ImagineXYZ/GPSPassive/Pics/IMG-20160824-WA0027.jpg

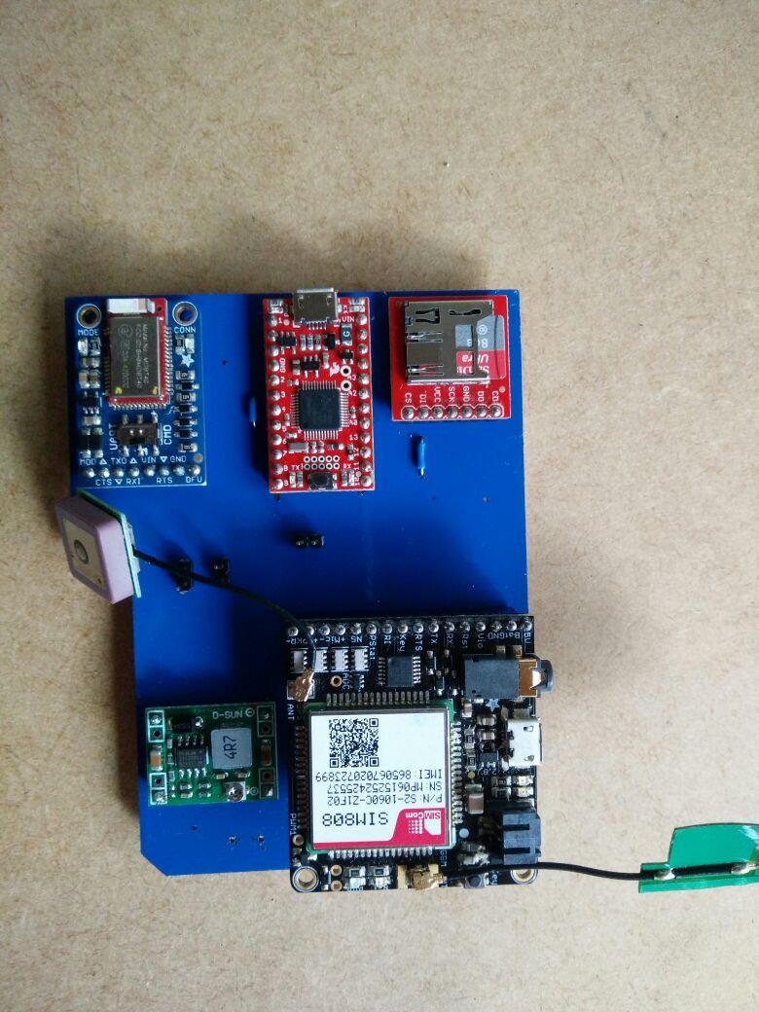
Pics/IMG-20160824-WA0027.jpg
