ImagineXYZ/GPSPassive/Pics/IMG-20160824-WA0009.jpg

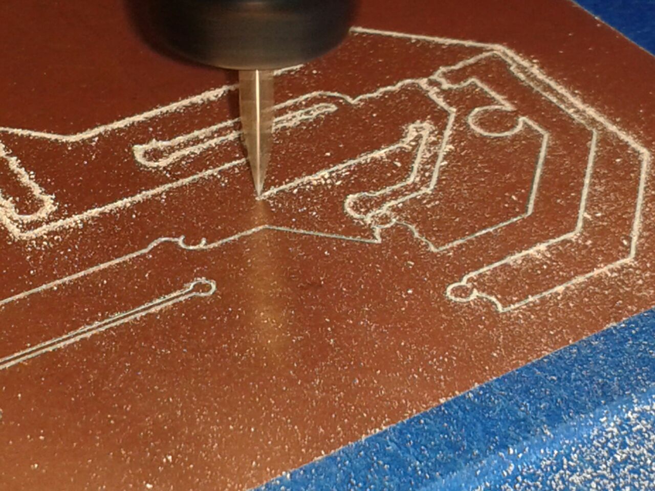
Pics/IMG-20160824-WA0009.jpg
