ImagineXYZ/GPSPassive/Hardware/BLE/ReadMe.txt

Circuitería para el Módulo de Bluetooth de Nordic Semiconductor
Modelo: nRF51822
Link: https://www.nordicsemi.com/eng/Products/Bluetooth-low-energy/nRF51822
