ImagineXYZ/GPSPassive/Hardware/FONA/Readme.txt

Circuitería de soporte para SIM808 en montaje superficial.
Se siguen recomendaciones de la hoja de datos del dispositivo.
