ImagineXYZ/GPSPassive/Hardware/SAMD21/Readme.txt

Circuito necesario para el funcionamiento e interfaz del SAMD21.
