ImagineXYZ/GPSPassive/Hardware/Flash/Readme.txt

Memoria Flash para tarjeta de desarrollo de Hardware (GPSPassive)

Datos de memoria flash de 1GB con comunicación SPI

Modelo: S70FL01GSAGMFI011
