ImagineXYZ/GPSPassive/Hardware/Flash/ComponentePCB/DS/S70FL01_Breakout (PCB - PLOT REPORT).txt

PLOT REPORT
-----------

Report File:        C:\Users\Bryan\Documents\Trabajo\ImagineXYZ\HarwareDevelopment\Git\GPSPassive\Hardware\Flash\ComponentePCB\DS\S70FL01_Breakout (PCB - PLOT REPORT).txt
Report Written:     Wednesday, August 24, 2016
Project Path:       C:\Users\Bryan\Documents\Trabajo\ImagineXYZ\HarwareDevelopment\Git\GPSPassive\Hardware\Flash\ComponentePCB\DS\S70FL01GSAGMFI011_Breakout.prj
Design Path:        C:\Users\Bryan\Documents\Trabajo\ImagineXYZ\HarwareDevelopment\Git\GPSPassive\Hardware\Flash\ComponentePCB\DS\S70FL01_Breakout.pcb
Design Title:       
Created:            16/08/2016 11:09:58 a.m.
Last Saved:         18/08/2016 02:03:26 p.m.
Editing Time:       46 min
Units:              mm (precision 3)

Device Settings
===============

Drill Settings
==============

    Excellon Format 1    Format 3.5 absolute in mm.
    No zero suppression.

Plots Output
============

    Plot Job: "C:\Users\Bryan\Documents\Trabajo\ImagineXYZ\HarwareDevelopment\Git\GPSPassive\Hardware\Flash\ComponentePCB\DS\S70FL01_Breakout.mop"

NC Drill Output
===============

C:\Users\Bryan\Documents\Trabajo\ImagineXYZ\HarwareDevelopment\Git\GPSPassive\Hardware\Flash\ComponentePCB\DS\S70FL01_Breakout - Drill Data - [Through Hole].drl

    Output:
    ---------------------------
    Plated Round Drill Holes
    Plated Slots
    Plated Board Outlines

    Tool  Size         Count   ID
    ------------------------------------
    T001  000.02362 in 16    F
    ------------------------------------
    Total              16
    ------------------------------------

C:\Users\Bryan\Documents\Trabajo\ImagineXYZ\HarwareDevelopment\Git\GPSPassive\Hardware\Flash\ComponentePCB\DS\S70FL01_Breakout - Drill Data - [Through Hole] (Unplated).drl

    Output:
    -----------------------------
    Unplated Round Drill Holes
    Unplated Slots
    Unplated Board Outlines

    Tool  Size         Count   ID
    ------------------------------------
    T001  000.02500 in 1
    ------------------------------------
    Total              1
    ------------------------------------

End Of Report.
