ImagineXYZ/GPSPassive/Hardware/BLE/Notas BLE.docx

El Adafruit Bluefruit LE UART integra un shield (MDBT40 de raytac) en su tarjeta de desarrollo que contiene el BLE nRF51822 de Nordic Semiconductor, la cual se utiliza en el primer prototipo

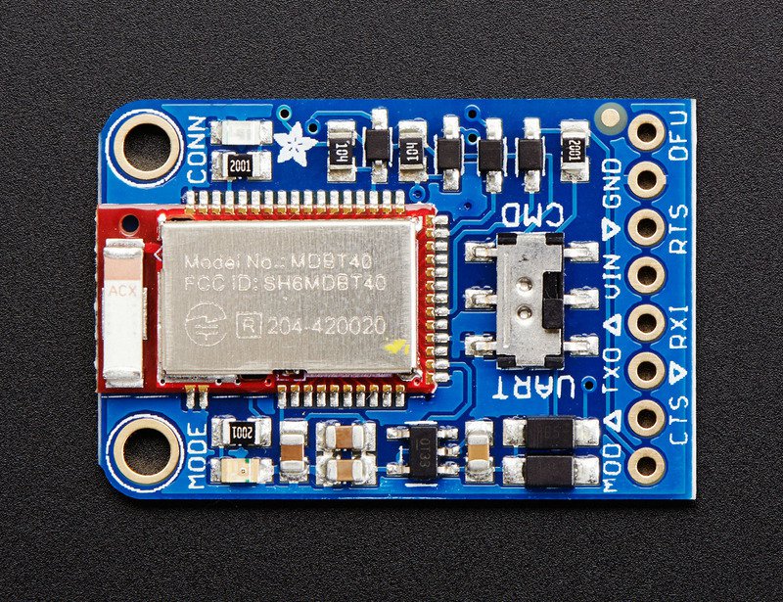
[picture p3: figure]

Configuración recomendada en la hoja de datos

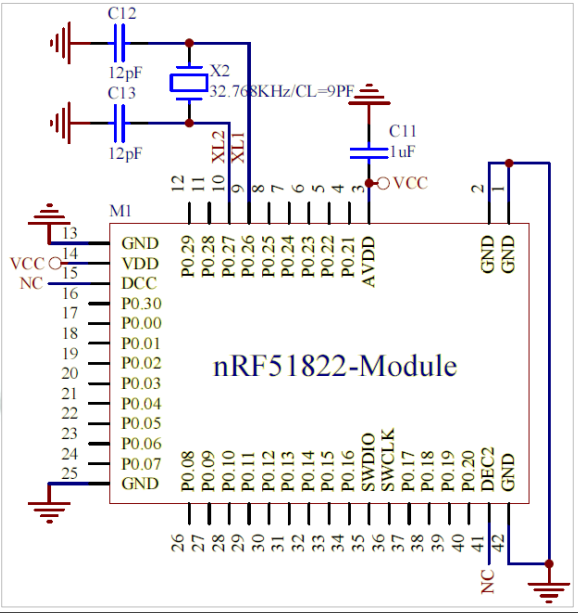
[picture p4: figure]
