ImagineXYZ/GPSPassive/Hardware/SAMD21/Notas SAMD21.docx

Notas SAMD21

Requerimientos de energía

-Se recomienda emplear el circuito a continuación (inductor 10uH)

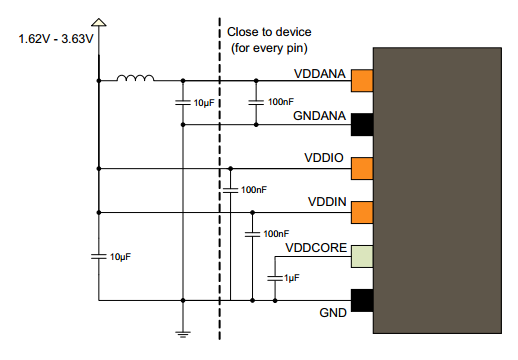
[picture p5: figure]

-Circuito recomendado para reset

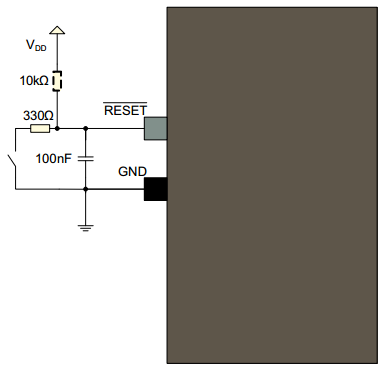
[picture p6: figure]

Requerimientos de reloj

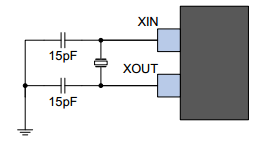
[picture p7: figure]

-Se debe colocar el cristal lo más cerca posible del dispositivo

Recomendaciones de comunicación/debug

-JTAG 10 pines (JTAGICE3)

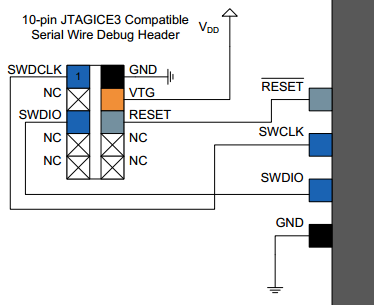
[picture p8: figure]

-USB (circuito recomendado)

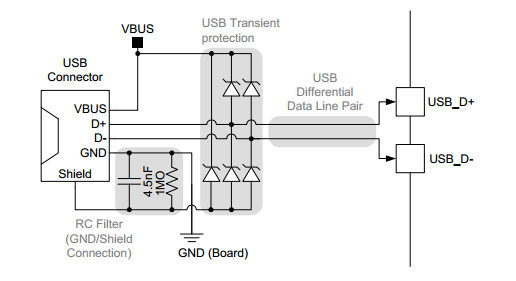
[picture p9: figure]

-Utilizar como referencia circuito de Adafruit Feather

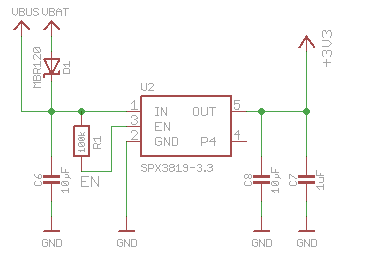
[picture p10: figure]
