ImagineXYZ/GPSPassive/Hardware/SD/Readme.txt

Memoria SD para tarjeta de desarrollo de Hardware (GPSPassive)

Datos de uso de memorias SD en conjunto con el SAMD21
