ImagineXYZ/GPSPassive/Hardware/Flash/Docs/Notas.txt

.No se ha encontrado una biblioteca de componentes de eagle con el componente
