ImagineXYZ/GPSPassive/Hardware/Flash/ComponentePCB/DS/Breakout_S70FL01.png

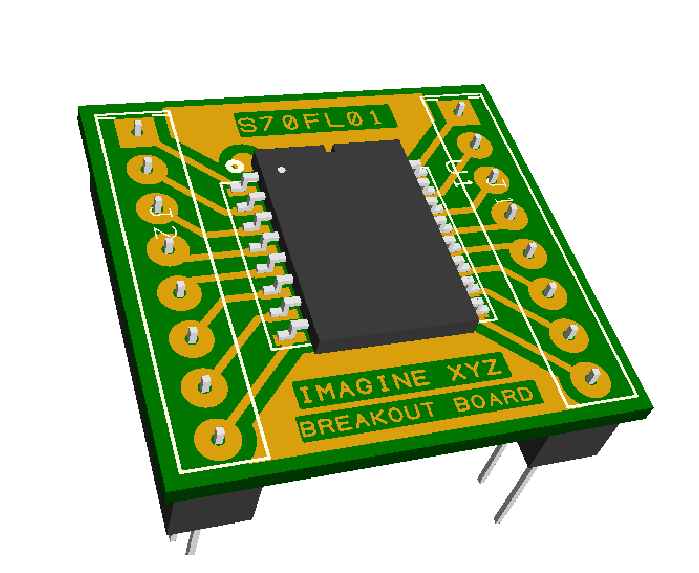
Hardware/Flash/ComponentePCB/DS/Breakout_S70FL01.png
