ImagineXYZ/GPSPassive/Hardware/FONA/Docs/adafruit_products_808schem.png

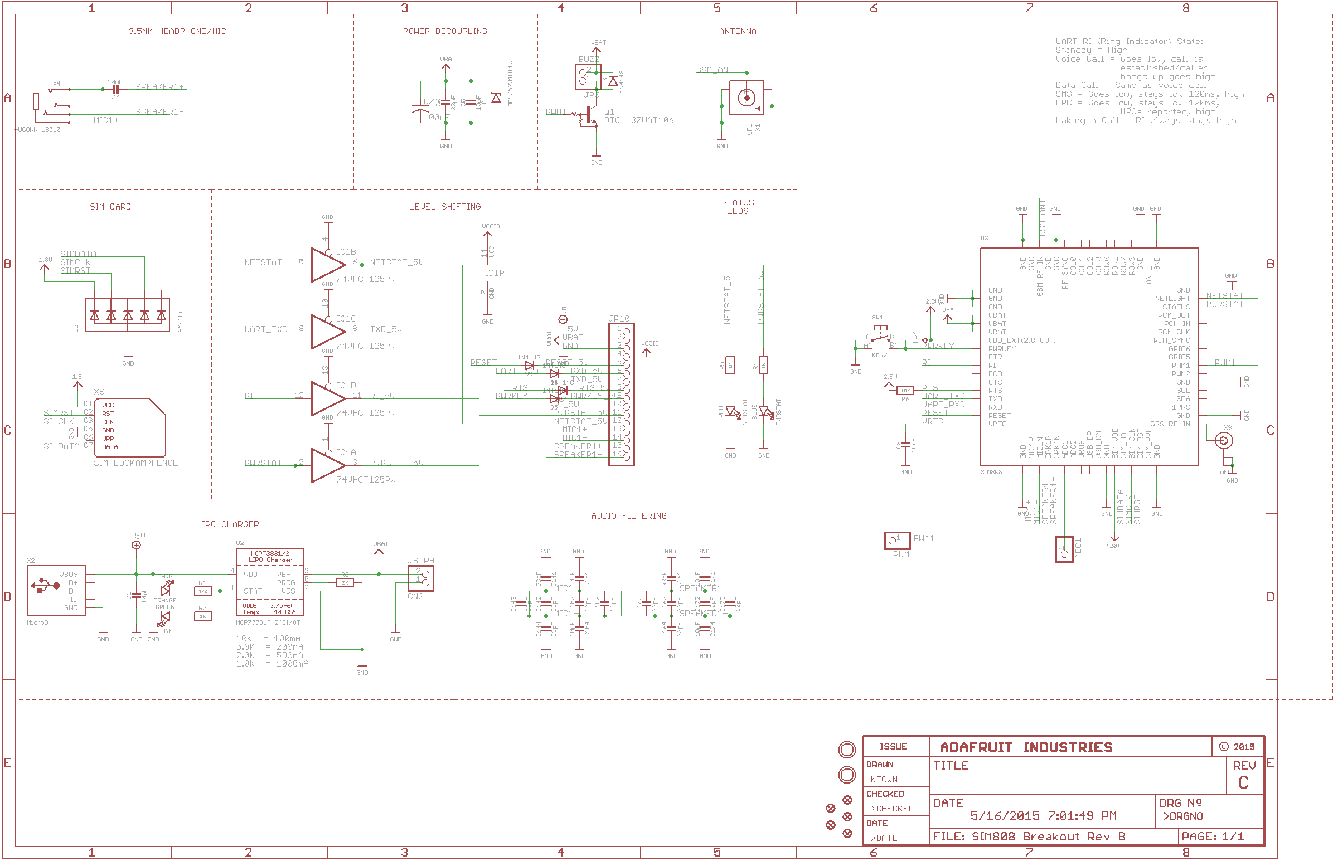
Hardware/FONA/Docs/adafruit_products_808schem.png
