ImagineXYZ/GPSPassive/Pics/IMG-20160623-WA0019.jpg

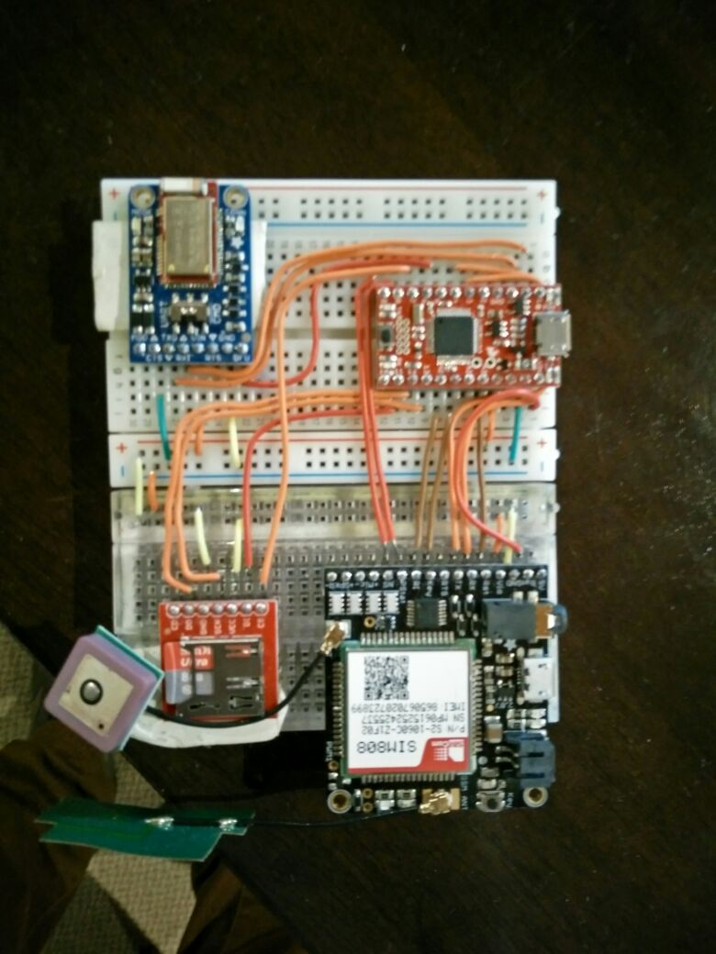
Pics/IMG-20160623-WA0019.jpg
