ImagineXYZ/GPSPassive/Pics/IMG-20160824-WA0017.jpeg

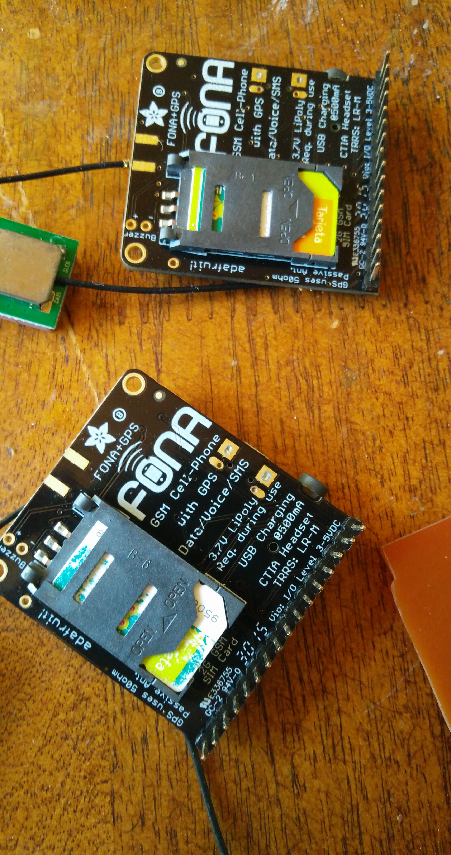
Pics/IMG-20160824-WA0017.jpeg
