ImagineXYZ/GPSPassive/Pics/IMG-20160824-WA0019.jpg

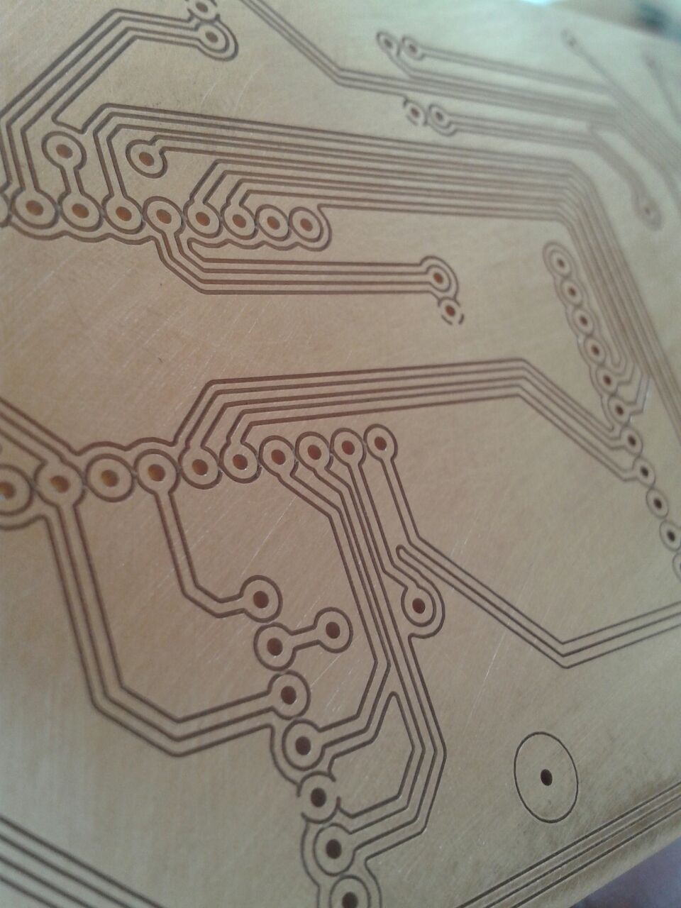
Pics/IMG-20160824-WA0019.jpg
