ImagineXYZ/GPSPassive/Pics/IMG-20160824-WA0020.jpg

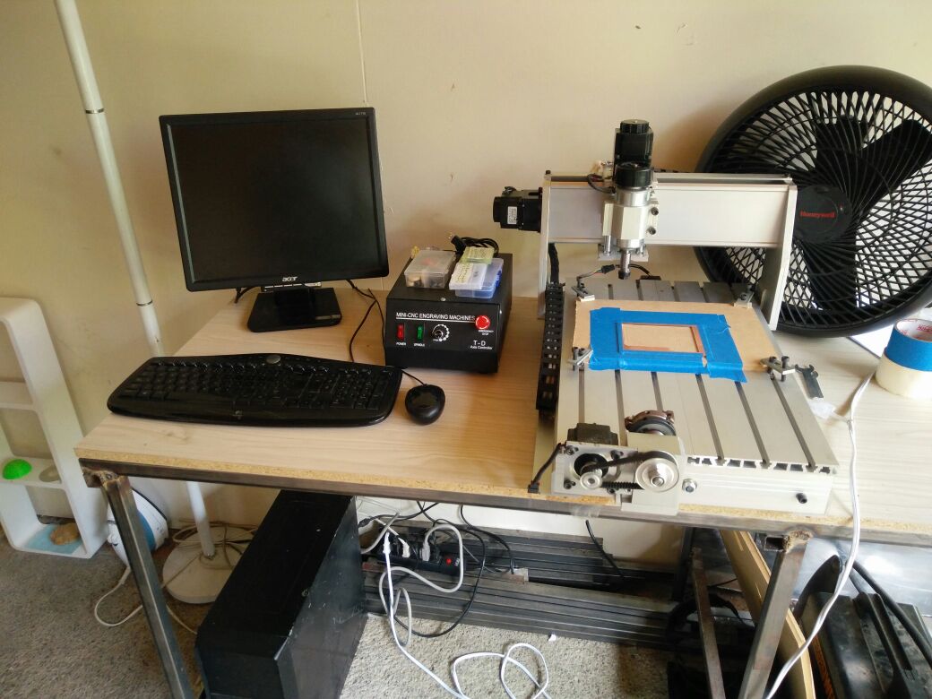
Pics/IMG-20160824-WA0020.jpg
