ImagineXYZ/GPSPassive/Pics/IMG-20160824-WA0023.jpg

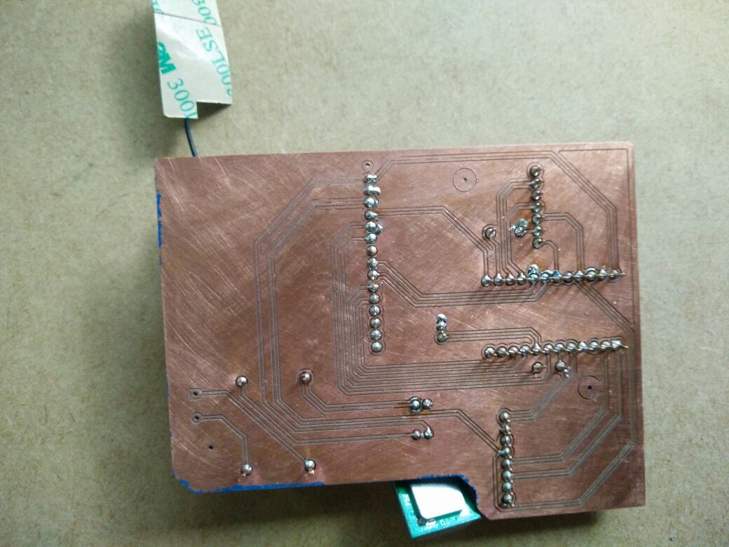
Pics/IMG-20160824-WA0023.jpg
