ImagineXYZ/GPSPassive/Pics/IMG-20160825-WA0015.jpg

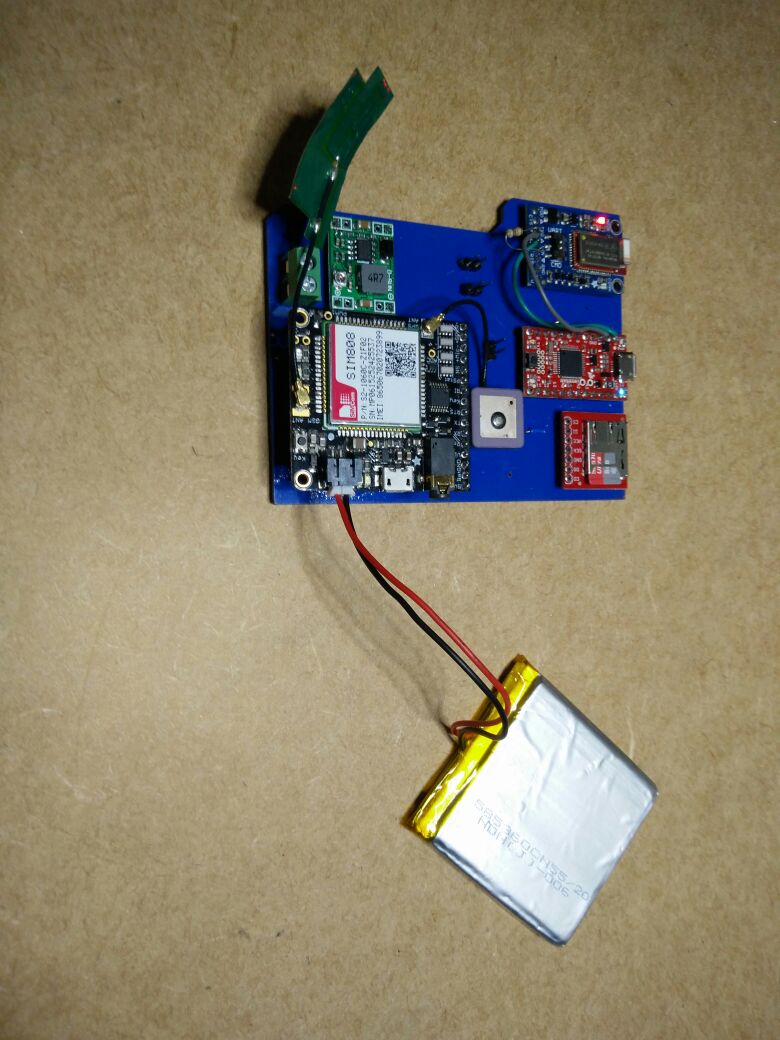
Pics/IMG-20160825-WA0015.jpg
