ImagineXYZ/GPSPassive/Pics/IMG-20160825-WA0016.jpg

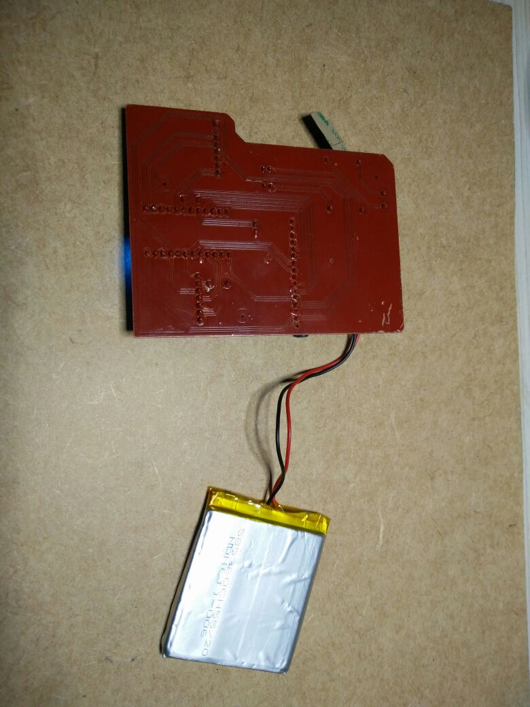
Pics/IMG-20160825-WA0016.jpg
