ImagineXYZ/GPSPassive/Protocolo BT/Diagrama Secuencia BT.png

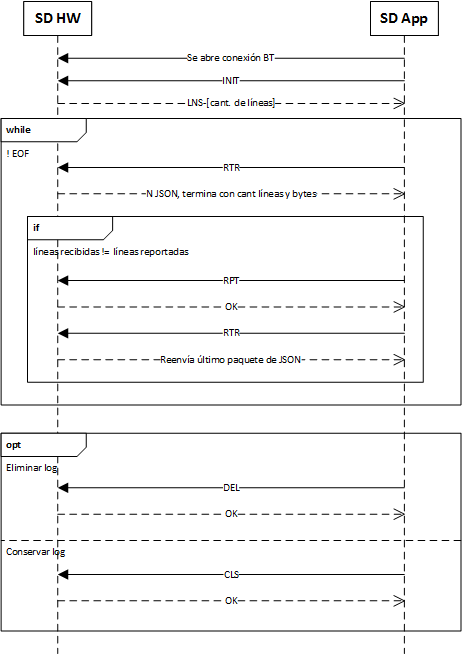
Protocolo BT/Diagrama Secuencia BT.png
