ImagineXYZ/GPSPassive/Hardware/Flash/ComponentePCB/DS/Printing Imprimir.pdf

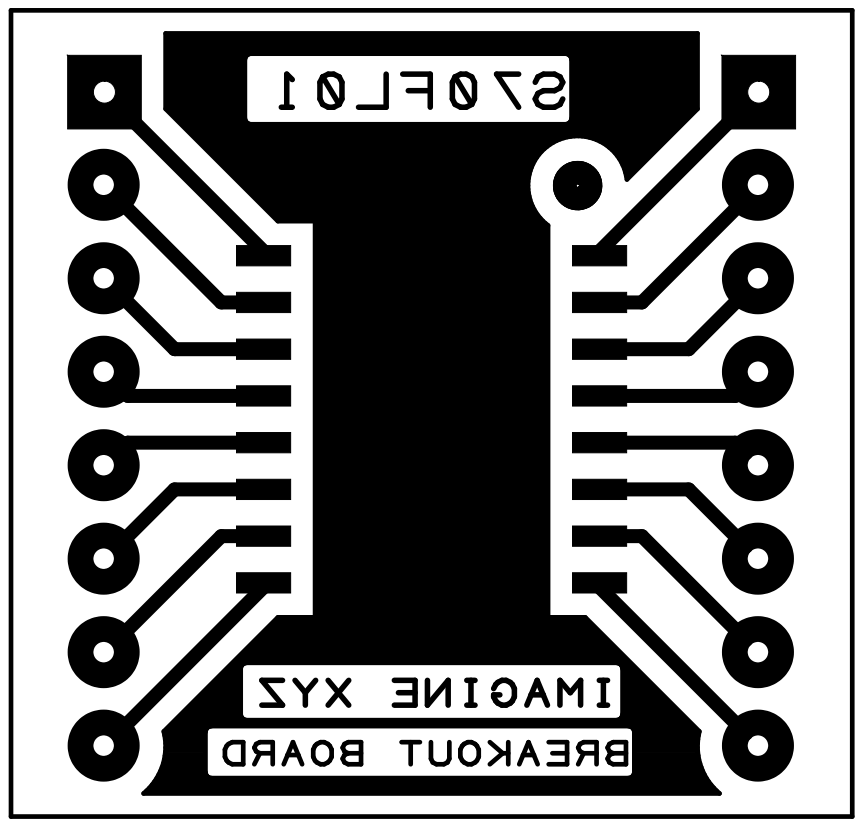
[picture p34: page 1]
