ImagineXYZ/GPSPassive/Hardware/Flash/ComponentePCB/DS/S70FL01_Breakout - PCB.pdf

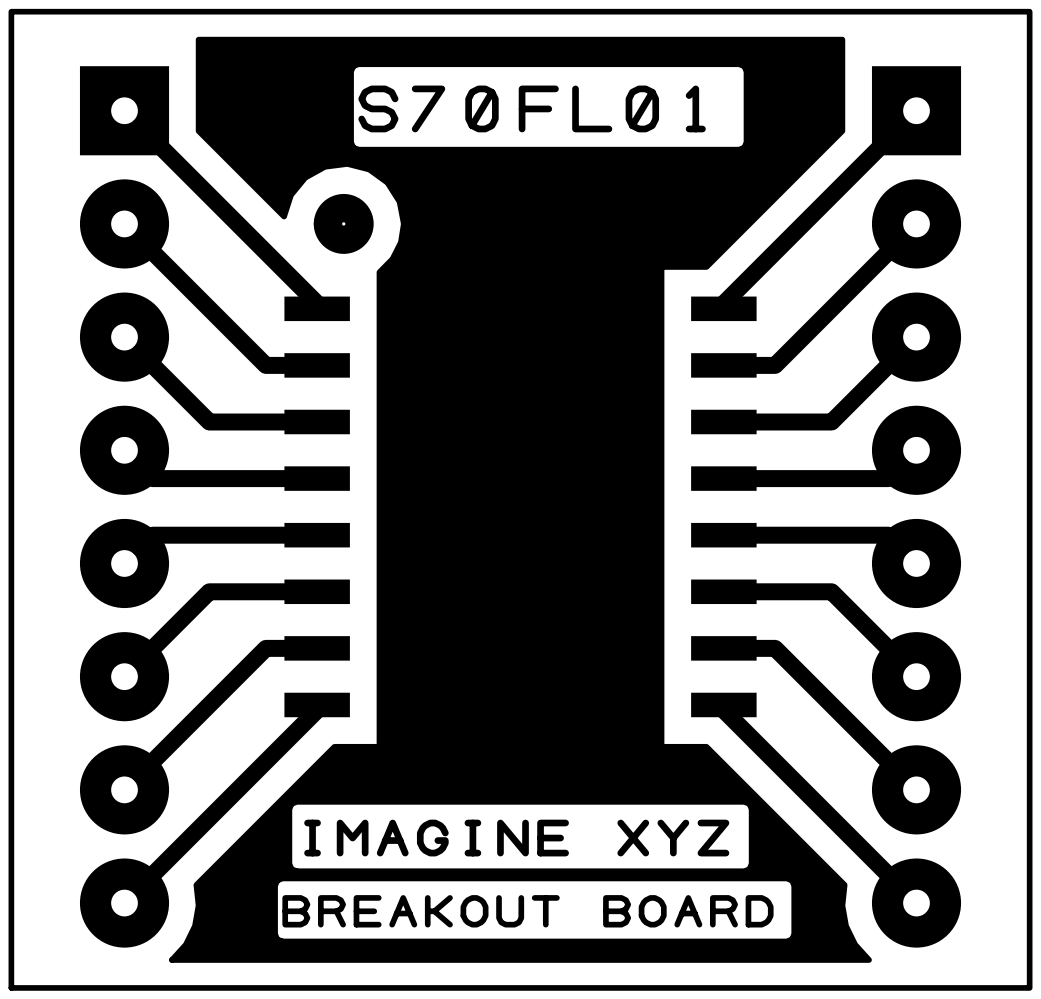
[picture p35: page 1]
