ImagineXYZ/GPSPassive/Eagle Files/RAC.pdf

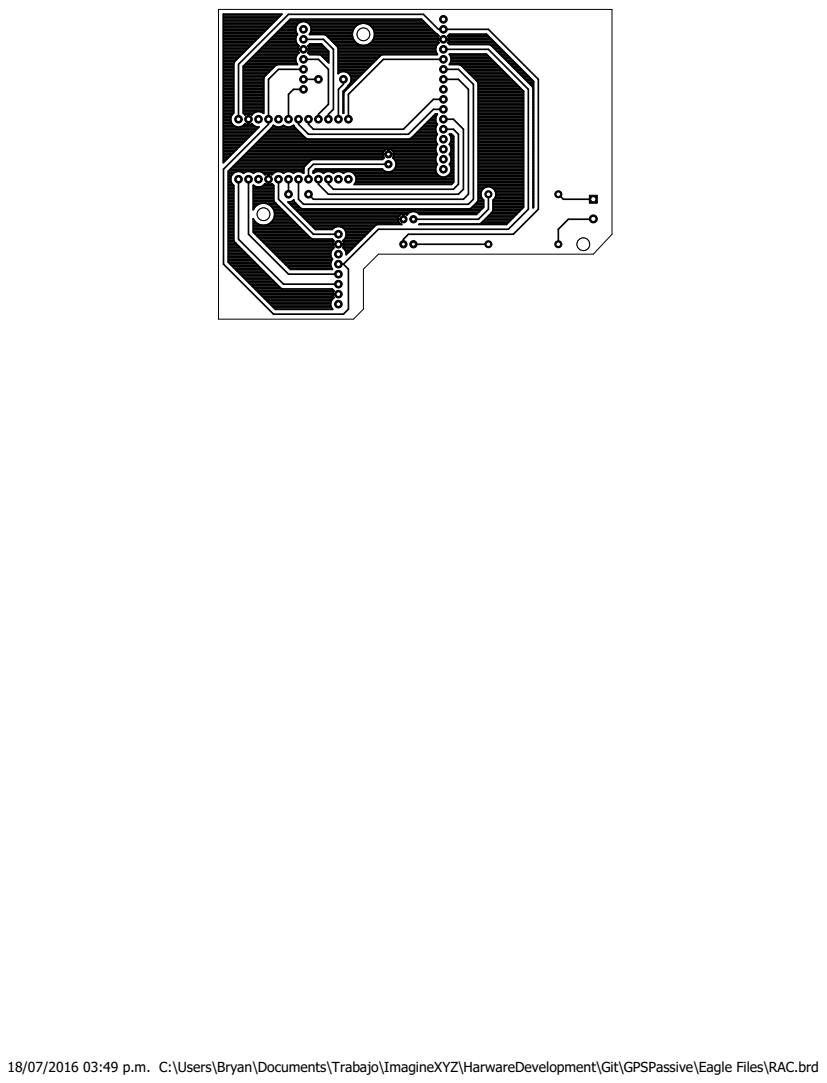
[picture p36: page 1]

18/07/2016 03:49 p.m. C:\Users\Bryan\Documents\Trabajo\ImagineXYZ\HarwareDevelopment\Git\GPSPassive\Eagle Files\RAC.brd
