ImagineXYZ/GPSPassive/(list of files, drawings)

Other design files:
Hardware/Flash/ComponentePCB/DS/S70FL01_Breakout.pcb
Hardware/Flash/ComponentePCB/DS/~S70FL01_Breakout.pcb
