ImagineXYZ/GPSPassive/Eagle Files/GPSPassive.brd

## EAGLE design Eagle Files/GPSPassive.brd (2016-08-31)

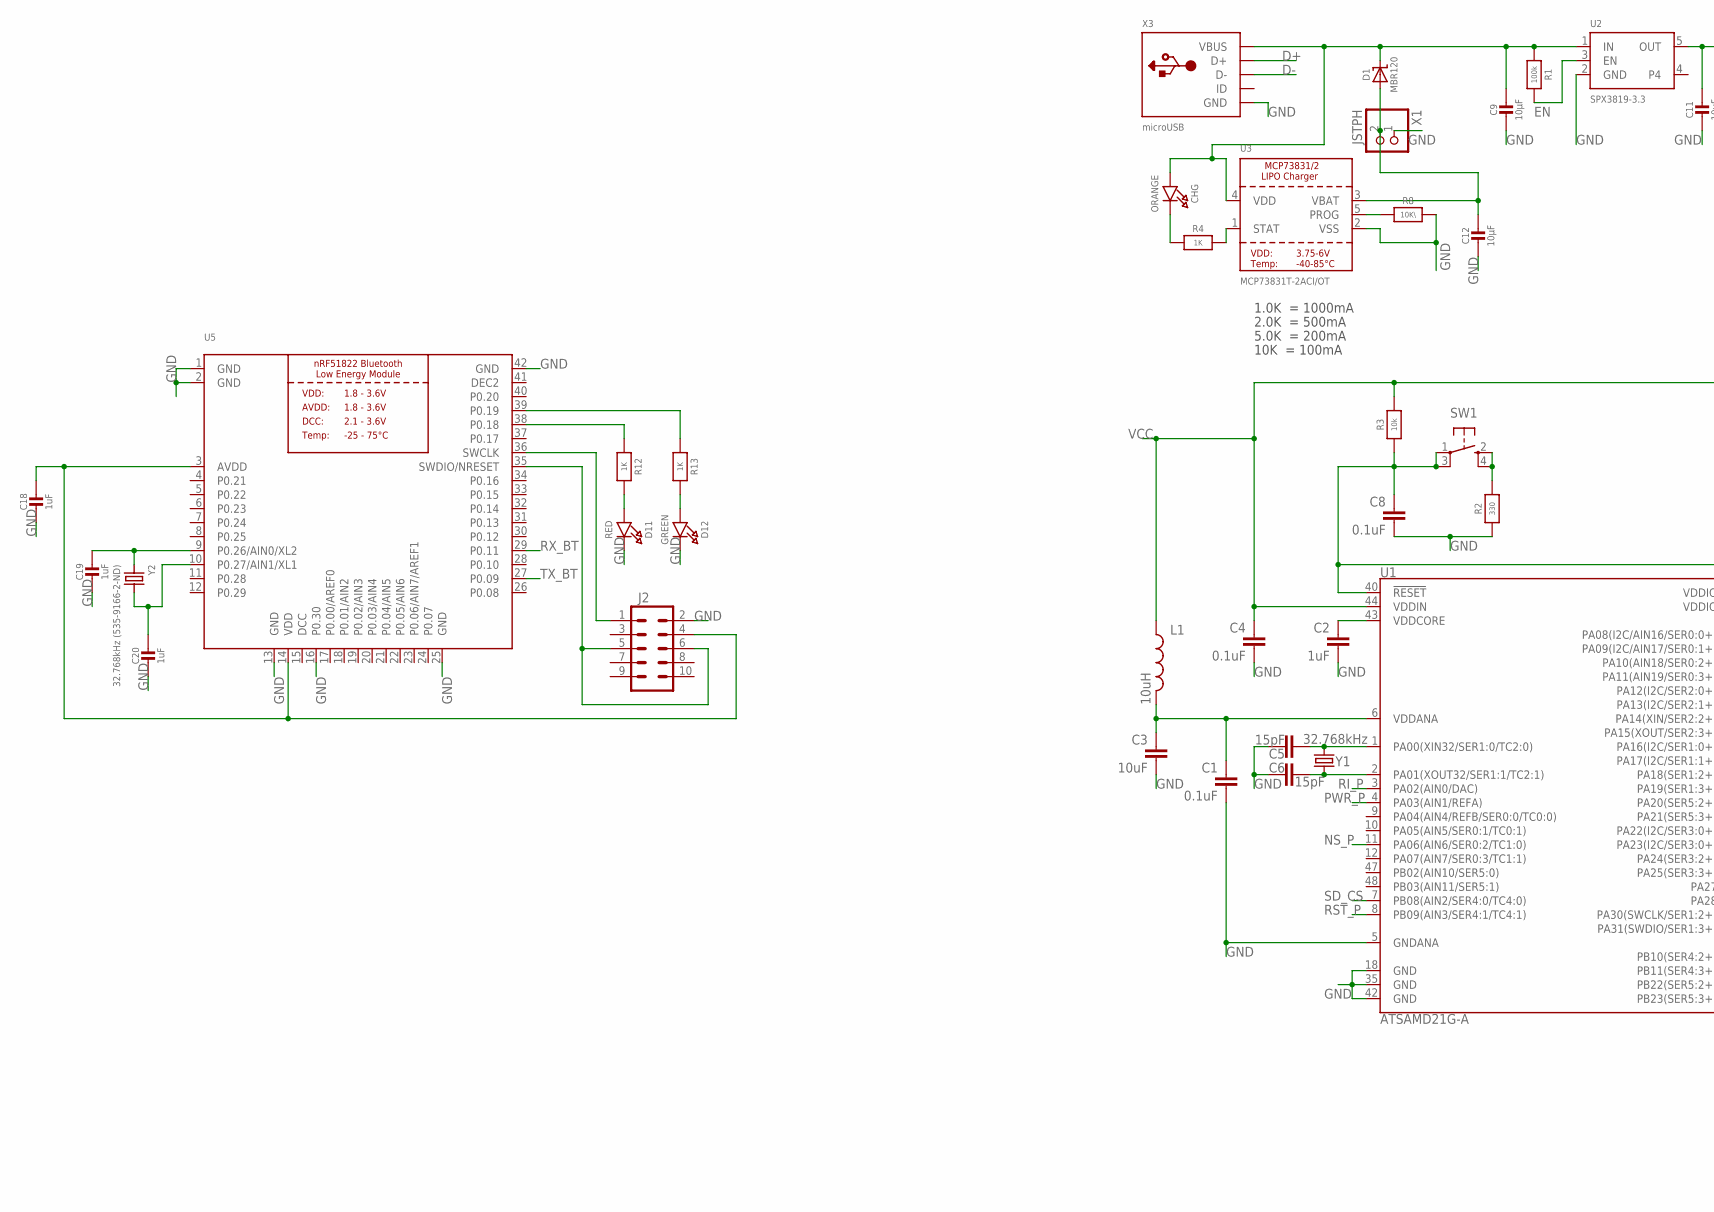
[picture p37: schematic GPSPassive.sch, part in row 1, column 1]

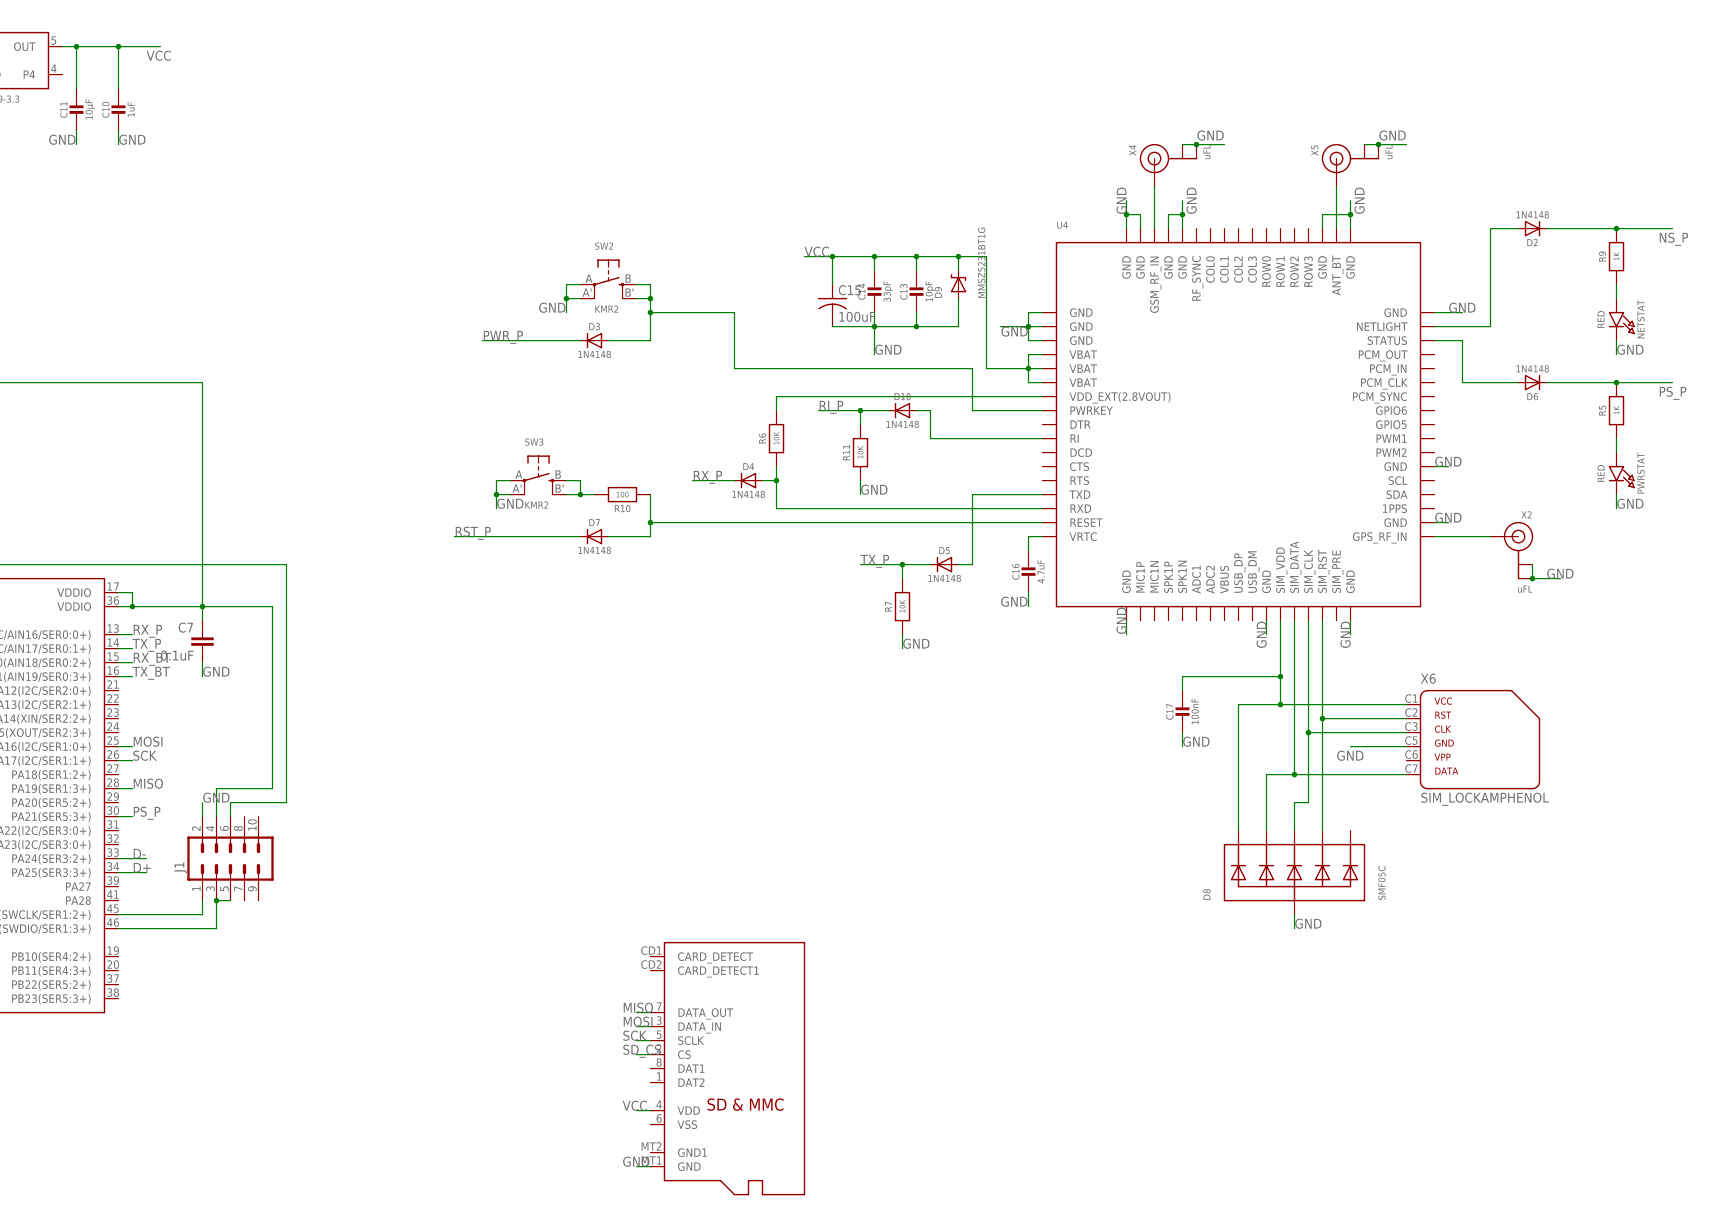
[picture p38: schematic GPSPassive.sch, part in row 1, column 2]

Parts:
C1, C4, C7, C8: 0.1uF; 0402-CAP
C2: 1uF; 0402-CAP
C3: 10uF; 0402-CAP
C5, C6: 15pF; 0402-CAP
C9, C11, C12: 10µF; 0805-NO
C10: 1uF; 0603-NO
C13: 10pF; 0805-NO
C14: 33pF; 0805-NO
C15: 100uF; C1210
C16: 4.7uF; 0805-NO
C17: 100nF; 0805-NO
C18, C19, C20: 1uF; 0805-NO
CHG: ORANGE; CHIPLED_0805_NOOUTLINE
D1: MBR120; SOD-123
D2, D3, D4, D5, D6, D7, D10: 1N4148; SOD-323
D8: SMF05C; SOT363
D9: MMSZ5231BT1G; SOD-123
D11: RED; CHIPLED_0805_NOOUTLINE
D12: GREEN; CHIPLED_0805_NOOUTLINE
J1, J2: M05X2SHD_LOCK; 2X5-SHROUDED_LOCK
L1: 10uH; 0603
NETSTAT: RED; CHIPLED_0805_NOOUTLINE
PWRSTAT: RED; CHIPLED_0805_NOOUTLINE
R1: 100k; 0603-NO
R2: 330; 0603-NO
R3: 10k; 0603-NO
R4: 1K; 0603-NO
R5, R9, R12, R13: 1K; 0805-NO
R6, R7, R11: 10K; 0805-NO
R8: 10K\; 0603-NO
R10: 100; 0805-NO
SW1: SPST_TACT-KMR2; KMR2
SW2, SW3: KMR2; BTN_KMR2_4.6X2.8
U1: ATSAMD21G-A; TQFP-48
U2: SPX3819-3.3; SOT23-5
U3: MCP73831T-2ACI/OT; SOT23-5
U4: GSM_SIM808_LITERAL; SIM900_SMT
U5: NRF51822_MODULE_MDBT40; BLE_MODULE_RAYTAC_MDBT40
U$1: MICROSD
X1: JSTPH; JSTPH2
X2, X4, X5: uFL; U.FL
X3: microUSB; 4UCONN_20329_V2
X6: SIM_LOCKAMPHENOL; C707_10M006_512_2
Y1: 32.768kHz; CRYSTAL-SMD-3.2X1.5MM
Y2: 32.768kHz (535-9166-2-ND); CRYSTAL_CYL_2X6MM_SMT

Connections:
!RESET: C8.1, J1.6, R3.1, SW1.1, SW1.3 (P1), U1.40 (!RESET!)
CONNECTED_LED: R13.1, U5.39 (P0.19)
D+: U1.34 (PA25(SER3:3+)), X3.D+
D-: U1.33 (PA24(SER3:2+)), X3.D-
DCC: U5.15 (DCC)
DEC2: U5.41 (DEC2)
EN: R1.2, U2.3 (EN)
GND: C1.2, C2.2, C3.2, C4.2, C5.1, C6.2, C7.2, C8.2, C9.2, C10.2, C11.2, C12.2, C13.2, C14.2, C15.2, C16.2, C17.2, C18.2, C19.2, C20.2, D8.2 (A), D9.A, D11.C, D12.C, J1.2, J2.2, NETSTAT.C, PWRSTAT.C, R2.1, R7.1, R8.2, R11.1, SW2.A, SW2.A' (P1), SW3.A, SW3.A' (P1), U1.5 (GNDANA), U1.18 (GND), U1.35 (GND), U1.42 (GND), U2.2 (GND), U3.2 (VSS), U4.P$1 (GND), U4.P$2 (GND), U4.P$3 (GND), U4.P$18 (GND), U4.P$28 (GND), U4.P$34 (GND), U4.P$36 (GND), U4.P$40 (GND), U4.P$51 (GND), U4.P$52 (GND), U4.P$54 (GND), U4.P$64 (GND), U4.P$65 (GND), U4.P$67 (GND), U4.P$68 (GND), U5.1 (GND), U5.2 (GND), U5.13 (GND), U5.16 (P0.30), U5.25 (GND), U5.42 (GND), U$1.MT1 (GND), X1.1, X2.1 (GND), X2.2 (GND), X3.BASE@1 (GND), X3.BASE@2 (GND), X3.GND, X3.SPRT@1 (GND), X3.SPRT@2 (GND), X3.SPRT@3 (GND), X3.SPRT@4 (GND), X4.1 (GND), X4.2 (GND), X5.1 (GND), X5.2 (GND), X6.C5 (4)
MISO: U1.28 (PA19(SER1:3+)), U$1.7 (DATA_OUT)
MODE_LED: R12.1, U5.38 (P0.18)
MOSI: U1.25 (PA16(I2C/SER1:0+)), U$1.3 (DATA_IN)
unnamed: C2.1, U1.43 (VDDCORE)
unnamed: C5.2, U1.1 (PA00(XIN32/SER1:0/TC2:0)), Y1.P$2 (2)
unnamed: J1.1, U1.45 (PA30(SWCLK/SER1:2+))
unnamed: C6.1, U1.2 (PA01(XOUT32/SER1:1/TC2:1)), Y1.P$1 (1)
unnamed: J1.3, J1.5, U1.46 (PA31(SWDIO/SER1:3+))
unnamed: C16.1, U4.P$17 (VRTC)
unnamed: R2.2, SW1.2 (S), SW1.4 (S1)
unnamed: R6.2, U4.P$7 (VDD_EXT(2.8VOUT))
unnamed: C12.1, D1.A, U3.3 (VBAT), X1.2
unnamed: CHG.C, R4.1
unnamed: D4.A, R6.1, U4.P$15 (RXD)
unnamed: R4.2, U3.1 (STAT)
unnamed: R8.1, U3.5 (PROG)
unnamed: C9.1, CHG.A, D1.C, R1.1, U2.1 (IN), U3.4 (VDD), X3.VBUS
unnamed: D5.A, U4.P$14 (TXD)
unnamed: D8.5 (C4), U4.P$32 (SIM_RST), X6.C2 (2)
unnamed: D8.4 (C3), U4.P$31 (SIM_CLK), X6.C3 (3)
unnamed: C17.1, D8.1 (C1), U4.P$29 (SIM_VDD), X6.C1 (1)
unnamed: D8.3 (C2), U4.P$30 (SIM_DATA), X6.C7 (6)
unnamed: NETSTAT.A, R9.1
unnamed: PWRSTAT.A, R5.1
unnamed: U4.P$66 (GSM_RF_IN), X4.3 (SIGNAL)
unnamed: U4.P$35 (GPS_RF_IN), X2.3 (SIGNAL)
unnamed: D10.A, U4.P$10 (RI)
unnamed: U4.P$53 (ANT_BT), X5.3 (SIGNAL)
unnamed: D11.A, R12.2
unnamed: D12.A, R13.2
unnamed: C19.1, U5.9 (P0.26/AIN0/XL2), Y2.1
unnamed: C20.1, U5.10 (P0.27/AIN1/XL1), Y2.2
unnamed: C18.1, J2.4, U5.3 (AVDD), U5.14 (VDD)
unnamed: J2.1, U5.36 (SWCLK)
unnamed: J2.5, J2.6, U5.35 (SWDIO/NRESET)
NS: D2.A, U4.P$50 (NETLIGHT)
NS_P: D2.C, R9.2, U1.11 (PA06(AIN6/SER0:2/TC1:0))
PS: D6.A, U4.P$49 (STATUS)
PS_P: D6.C, R5.2, U1.30 (PA21(SER5:3+))
PWRKEY: D3.A, SW2.B (S), SW2.B' (S1), U4.P$8 (PWRKEY)
PWRKEY2: R10.2, SW3.B (S), SW3.B' (S1)
PWR_P: D3.C, U1.4 (PA03(AIN1/REFA))
RI_P: D10.C, R11.2, U1.3 (PA02(AIN0/DAC))
RST: D7.A, R10.1, U4.P$16 (RESET)
RST_P: D7.C, U1.8 (PB09(AIN3/SER4:1/TC4:1))
RX_BT: U1.15 (PA10(AIN18/SER0:2+)), U5.29 (P0.11)
RX_P: D4.C, U1.13 (PA08(I2C/AIN16/SER0:0+))
SCK: U1.26 (PA17(I2C/SER1:1+)), U$1.5 (SCLK)
SD_CS: U1.7 (PB08(AIN2/SER4:0/TC4:0)), U$1.2 (CS)
TX_BT: U1.16 (PA11(AIN19/SER0:3+)), U5.27 (P0.09)
TX_P: D5.C, R7.2, U1.14 (PA09(I2C/AIN17/SER0:1+))
VBUS: U4.P$25 (VBUS)
VCC: C4.1, C7.1, C10.1, C11.1, C13.1, C14.1, C15.1, D9.C, J1.4, L1.1, R3.2, U1.17 (VDDIO), U1.36 (VDDIO), U1.44 (VDDIN), U2.5 (OUT), U4.P$4 (VBAT), U4.P$5 (VBAT), U4.P$6 (VBAT), U$1.4 (VDD)
VDDANA: C1.1, C3.1, L1.2, U1.6 (VDDANA)

Notes on the sheet:
10K = 100mA
5.0K = 200mA
2.0K = 500mA
1.0K = 1000mA

Board: 2 copper layers, 68 parts (0 on the bottom side), 59 nets, no tracks yet.
