ImagineXYZ/GPSPassive/Eagle Files/RAC.brd

## EAGLE design Eagle Files/RAC.brd (2016-08-31)

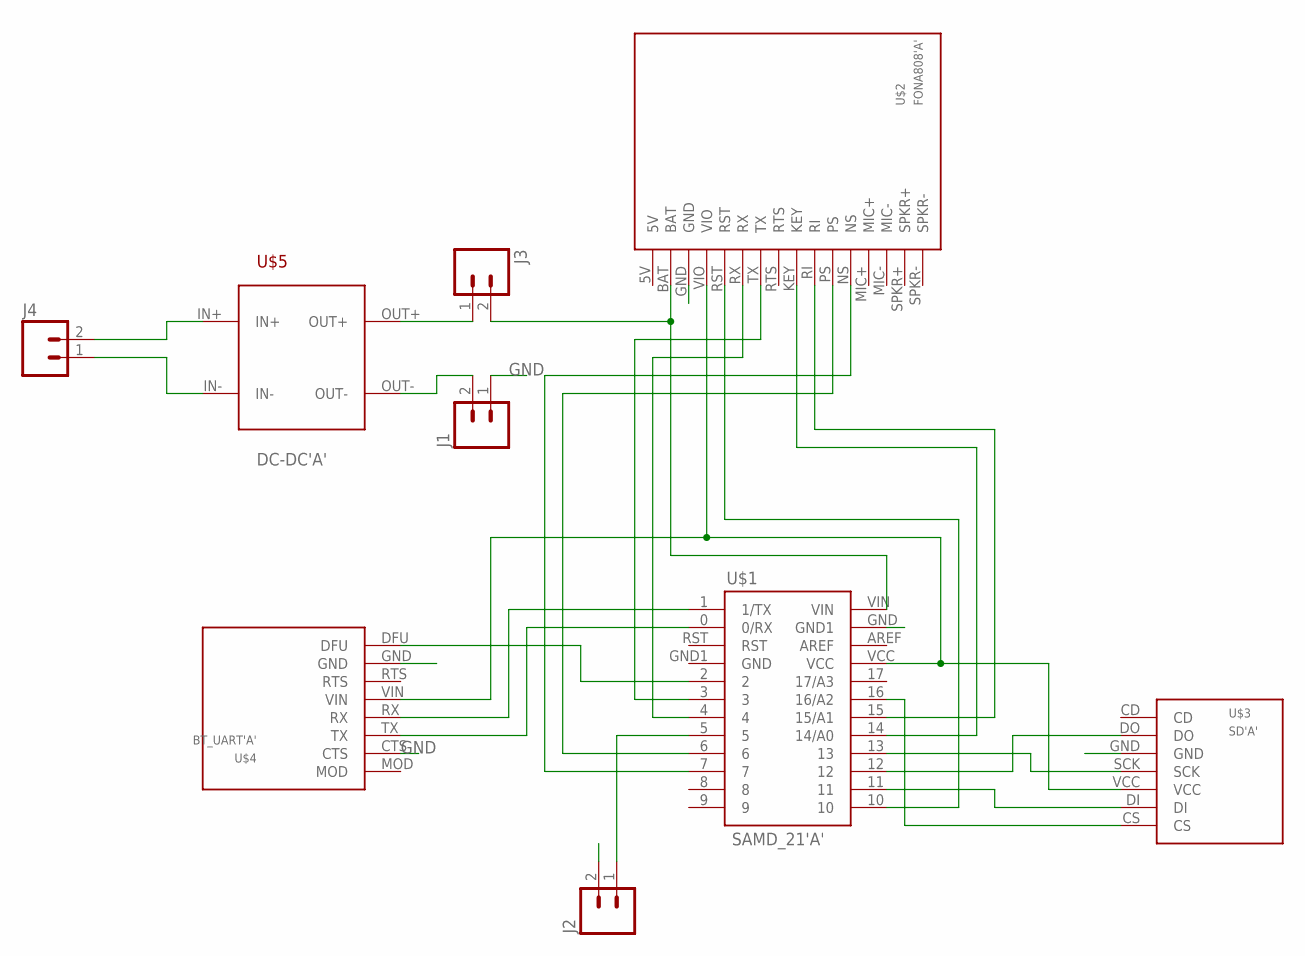
[picture p39: schematic RAC.sch]

Parts:
J1, J2, J3: M02PTH; 1X02
J4: M025MM; SCREWTERMINAL-5MM-2
U$1: SAMD_21'A'; MINI
U$2: FONA808'A'; FONA
U$3: SD'A'; SD_BR
U$4: BT_UART'A'; BLE
U$5: DC-DC'A'; DC-DC

Connections:
GND: J1.1, J2.2, U$1.GND (GND1), U$1.GND1 (GND), U$2.GND, U$3.GND, U$4.CTS, U$4.GND
unnamed: J3.2, U$1.VIN, U$2.BAT
unnamed: U$1.4, U$2.RX
unnamed: U$1.3, U$2.TX
unnamed: U$1.VCC, U$2.VIO, U$3.VCC, U$4.VIN
unnamed: U$1.14 (14/A0), U$2.KEY
unnamed: U$1.15 (15/A1), U$2.RI
unnamed: U$1.10, U$2.RST
unnamed: U$1.11, U$3.DI
unnamed: U$1.12, U$3.DO
unnamed: U$1.13, U$3.SCK
unnamed: U$1.16 (16/A2), U$3.CS
unnamed: U$1.0 (0/RX), U$4.TX
unnamed: U$1.2, U$4.DFU
unnamed: J3.1, U$5.OUT+
unnamed: J1.2, U$5.OUT-
unnamed: J4.2, U$5.IN+
unnamed: J4.1, U$5.IN-
S$1: J2.1, U$1.5
S$2: U$1.6, U$2.PS
S$3: U$1.7, U$2.NS
S$4: U$1.1 (1/TX), U$4.RX

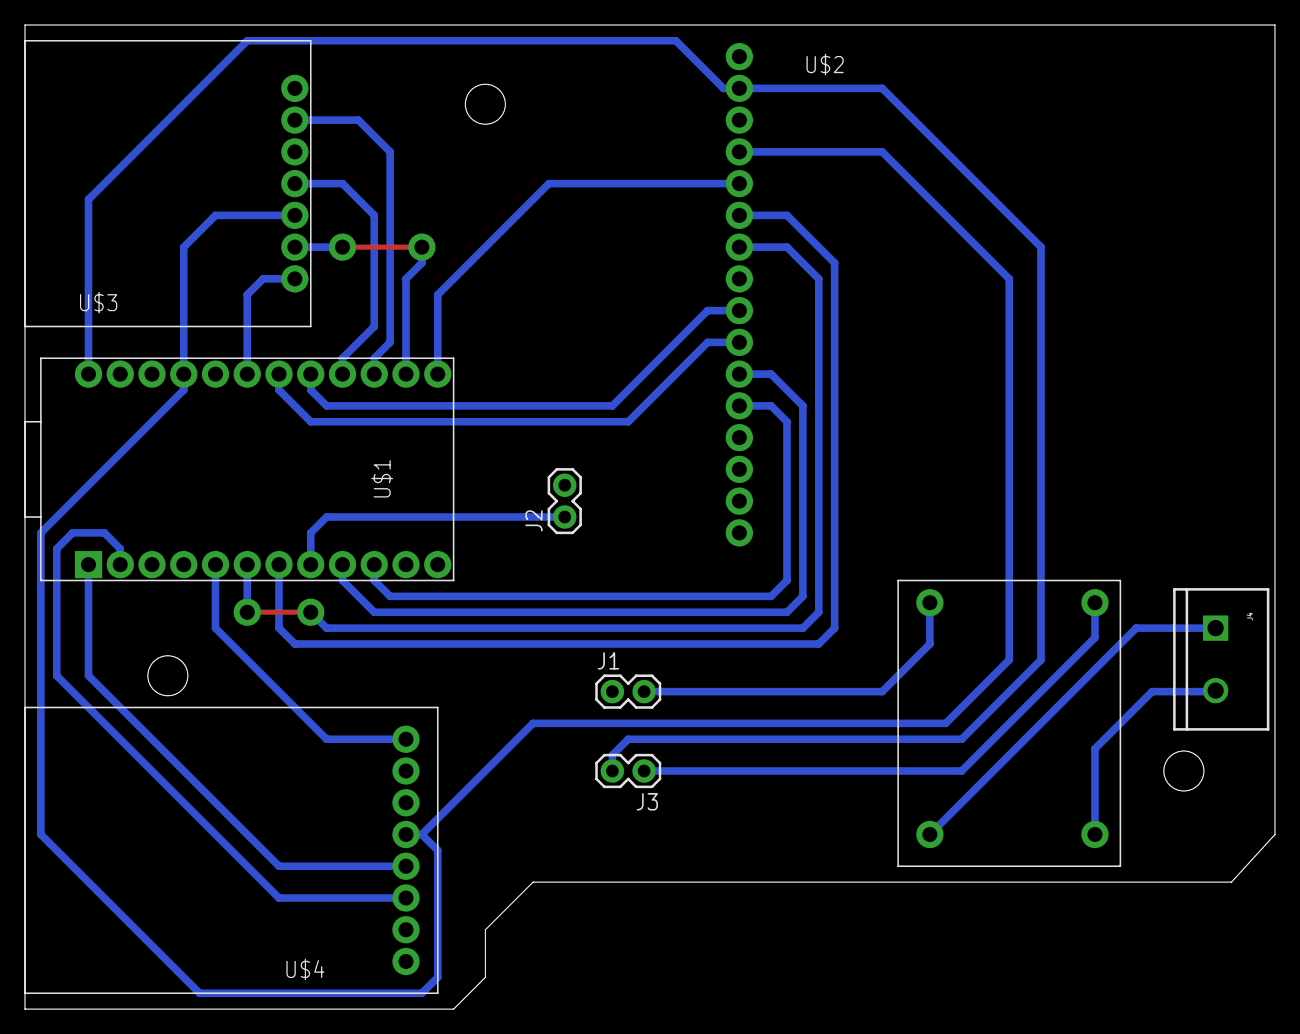
[picture p40: board RAC.brd from above]

Board: 2 copper layers, 100.0 x 78.7 mm, 9 parts (0 on the bottom side), 22 nets.
