ImagineXYZ/GPSPassive/Hardware/BLE/Eagle Files/BLE.sch

## EAGLE design Hardware/BLE/Eagle Files/BLE.sch (2016-08-23)

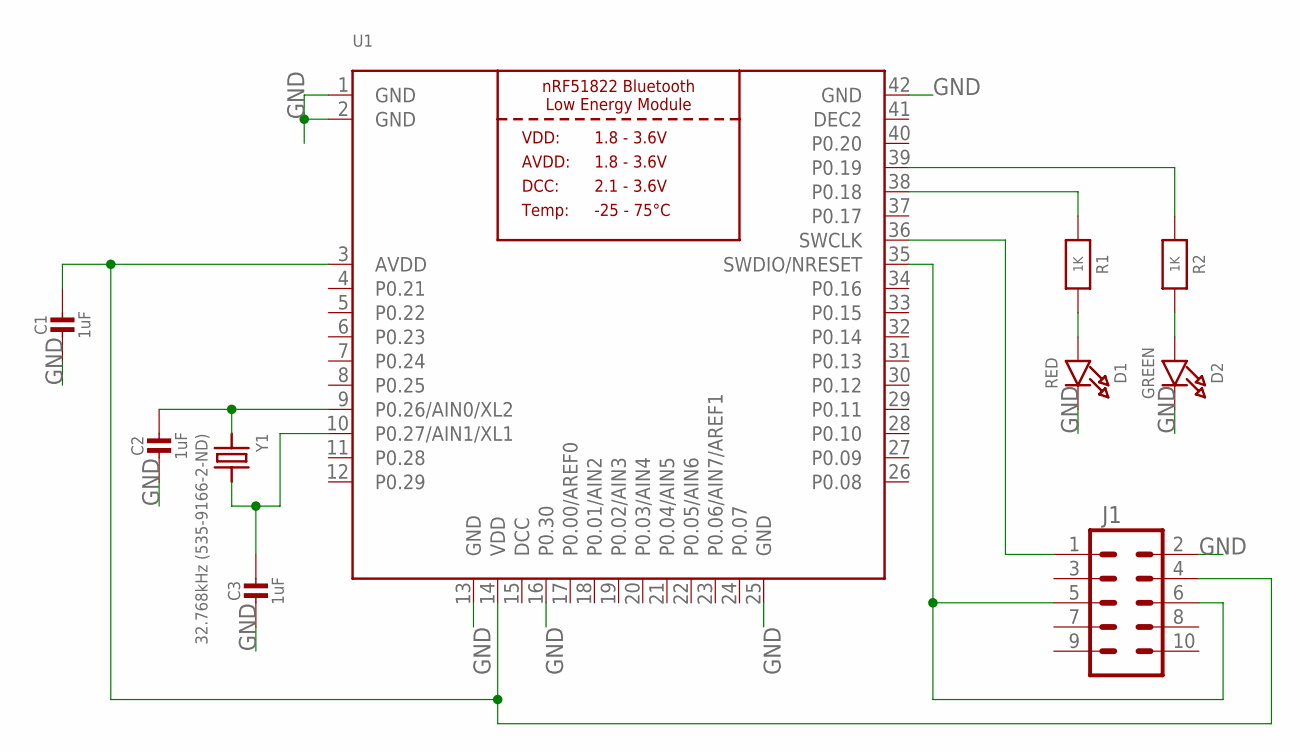
[picture p41: schematic BLE.sch]

Parts:
C1, C2, C3: 1uF; 0805-NO
D1: RED; CHIPLED_0805_NOOUTLINE
D2: GREEN; CHIPLED_0805_NOOUTLINE
J1: M05X2SHD_LOCK; 2X5-SHROUDED_LOCK
R1, R2: 1K; 0805-NO
U1: NRF51822_MODULE_MDBT40; BLE_MODULE_RAYTAC_MDBT40
Y1: 32.768kHz (535-9166-2-ND); CRYSTAL_CYL_2X6MM_SMT

Connections:
CONNECTED_LED: R2.1, U1.39 (P0.19)
GND: C1.2, C2.2, C3.2, D1.C, D2.C, J1.2, U1.1 (GND), U1.2 (GND), U1.13 (GND), U1.16 (P0.30), U1.25 (GND), U1.42 (GND)
MODE_LED: R1.1, U1.38 (P0.18)
unnamed: C2.1, U1.9 (P0.26/AIN0/XL2), Y1.1
unnamed: C3.1, U1.10 (P0.27/AIN1/XL1), Y1.2
unnamed: C1.1, J1.4, U1.3 (AVDD), U1.14 (VDD)
unnamed: J1.1, U1.36 (SWCLK)
unnamed: D1.A, R1.2
unnamed: D2.A, R2.2
unnamed: J1.5, J1.6, U1.35 (SWDIO/NRESET)
