ImagineXYZ/GPSPassive/Hardware/FONA/Eagle Files/SIM808.sch

## EAGLE design Hardware/FONA/Eagle Files/SIM808.sch (2016-08-12)

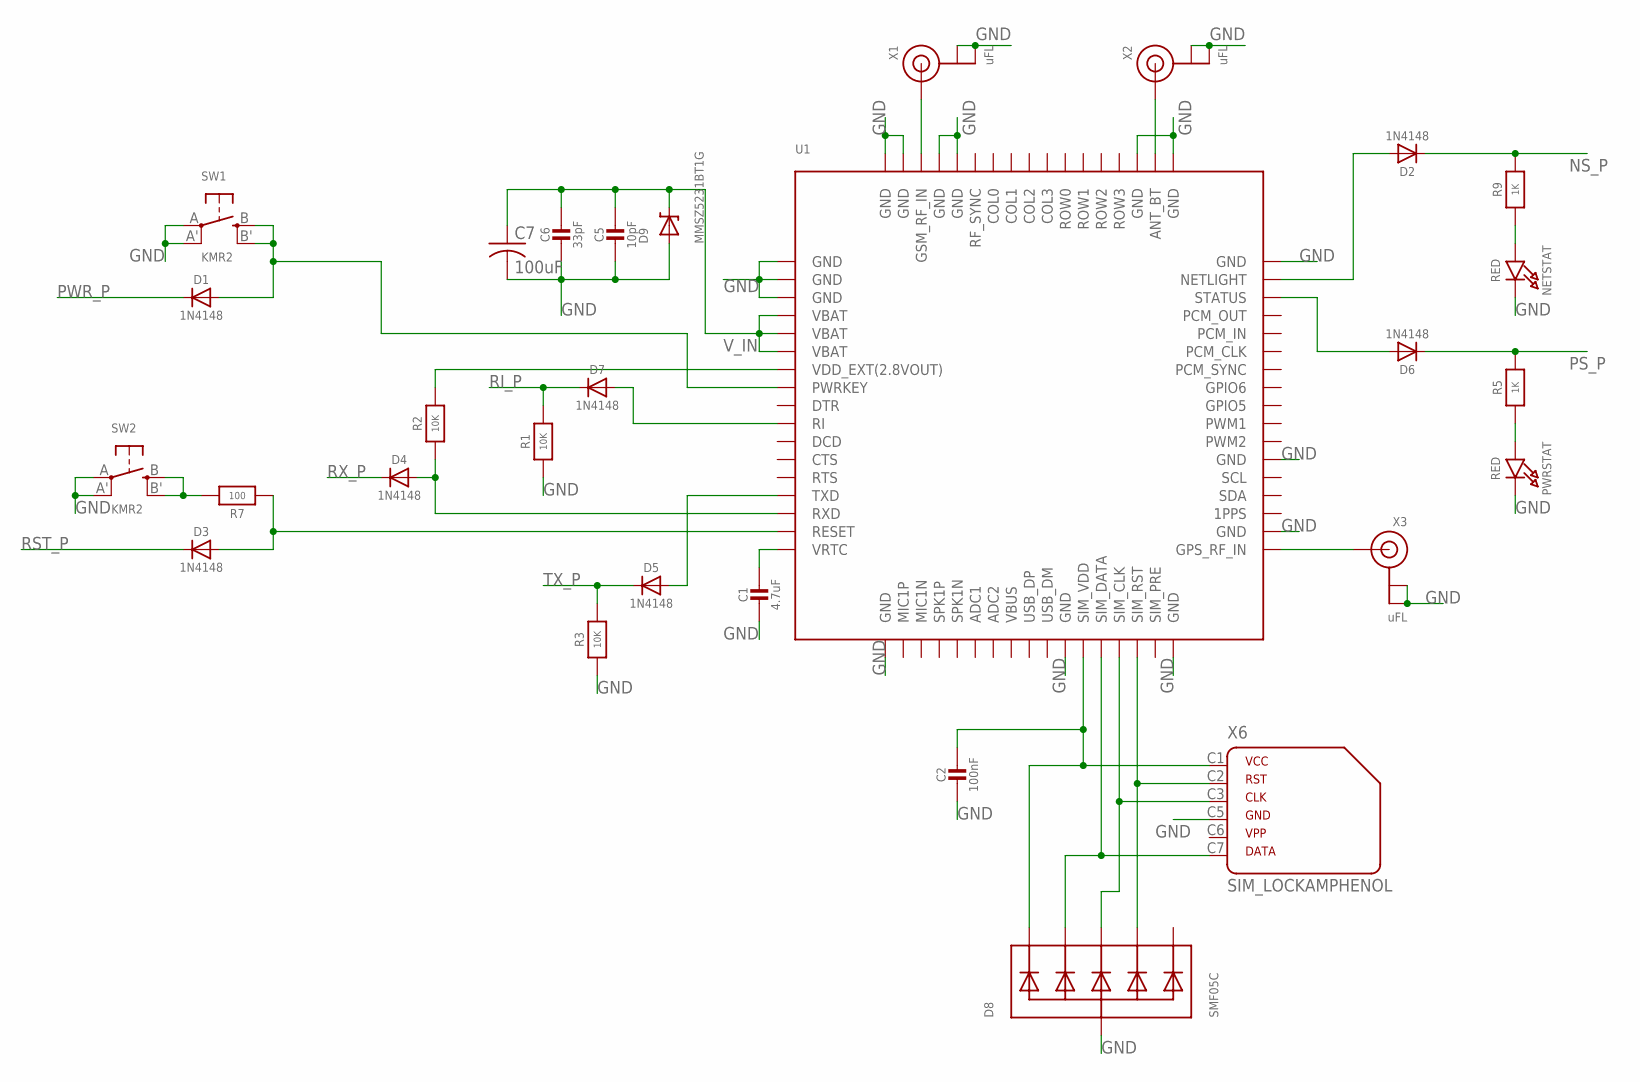
[picture p42: schematic SIM808.sch]

Parts:
C1: 4.7uF; 0805-NO
C2: 100nF; 0805-NO
C5: 10pF; 0805-NO
C6: 33pF; 0805-NO
C7: 100uF; C1210
D1, D2, D3, D4, D5, D6, D7: 1N4148; SOD-323
D8: SMF05C; SOT363
D9: MMSZ5231BT1G; SOD-123
NETSTAT: RED; CHIPLED_0805_NOOUTLINE
PWRSTAT: RED; CHIPLED_0805_NOOUTLINE
R1, R2, R3: 10K; 0805-NO
R5, R9: 1K; 0805-NO
R7: 100; 0805-NO
SW1, SW2: KMR2; BTN_KMR2_4.6X2.8
U1: GSM_SIM808_LITERAL; SIM900_SMT
X1, X2, X3: uFL; U.FL
X6: SIM_LOCKAMPHENOL; C707_10M006_512_2

Connections:
GND: C1.2, C2.2, C5.2, C6.2, C7.2, D8.2 (A), D9.A, NETSTAT.C, PWRSTAT.C, R1.1, R3.1, SW1.A, SW1.A' (P1), SW2.A, SW2.A' (P1), U1.P$1 (GND), U1.P$2 (GND), U1.P$3 (GND), U1.P$18 (GND), U1.P$28 (GND), U1.P$34 (GND), U1.P$36 (GND), U1.P$40 (GND), U1.P$51 (GND), U1.P$52 (GND), U1.P$54 (GND), U1.P$64 (GND), U1.P$65 (GND), U1.P$67 (GND), U1.P$68 (GND), X1.1 (GND), X1.2 (GND), X2.1 (GND), X2.2 (GND), X3.1 (GND), X3.2 (GND), X6.C5 (4)
unnamed: C1.1, U1.P$17 (VRTC)
unnamed: D7.A, U1.P$10 (RI)
unnamed: U1.P$35 (GPS_RF_IN), X3.3 (SIGNAL)
unnamed: R2.2, U1.P$7 (VDD_EXT(2.8VOUT))
unnamed: D4.A, R2.1, U1.P$15 (RXD)
unnamed: D5.A, U1.P$14 (TXD)
unnamed: PWRSTAT.A, R5.1
unnamed: D8.5 (C4), U1.P$32 (SIM_RST), X6.C2 (2)
unnamed: D8.4 (C3), U1.P$31 (SIM_CLK), X6.C3 (3)
unnamed: C2.1, D8.1 (C1), U1.P$29 (SIM_VDD), X6.C1 (1)
unnamed: U1.P$66 (GSM_RF_IN), X1.3 (SIGNAL)
unnamed: D8.3 (C2), U1.P$30 (SIM_DATA), X6.C7 (6)
unnamed: NETSTAT.A, R9.1
NS: D2.A, U1.P$50 (NETLIGHT)
NS_P: D2.C, R9.2
PS: D6.A, U1.P$49 (STATUS)
PS_P: D6.C, R5.2
PWRKEY: D1.A, SW1.B (S), SW1.B' (S1), U1.P$8 (PWRKEY)
PWRKEY2: R7.2, SW2.B (S), SW2.B' (S1)
PWR_P: D1.C
RI_P: D7.C, R1.2
RST: D3.A, R7.1, U1.P$16 (RESET)
RST_P: D3.C
RX_P: D4.C
TX_P: D5.C, R3.2
V_IN: C5.1, C6.1, C7.1, D9.C, U1.P$4 (VBAT), U1.P$5 (VBAT), U1.P$6 (VBAT)
