ImagineXYZ/GPSPassive/Hardware/SAMD21/Eagle Files/SAMD21.sch

## EAGLE design Hardware/SAMD21/Eagle Files/SAMD21.sch (2016-07-19)

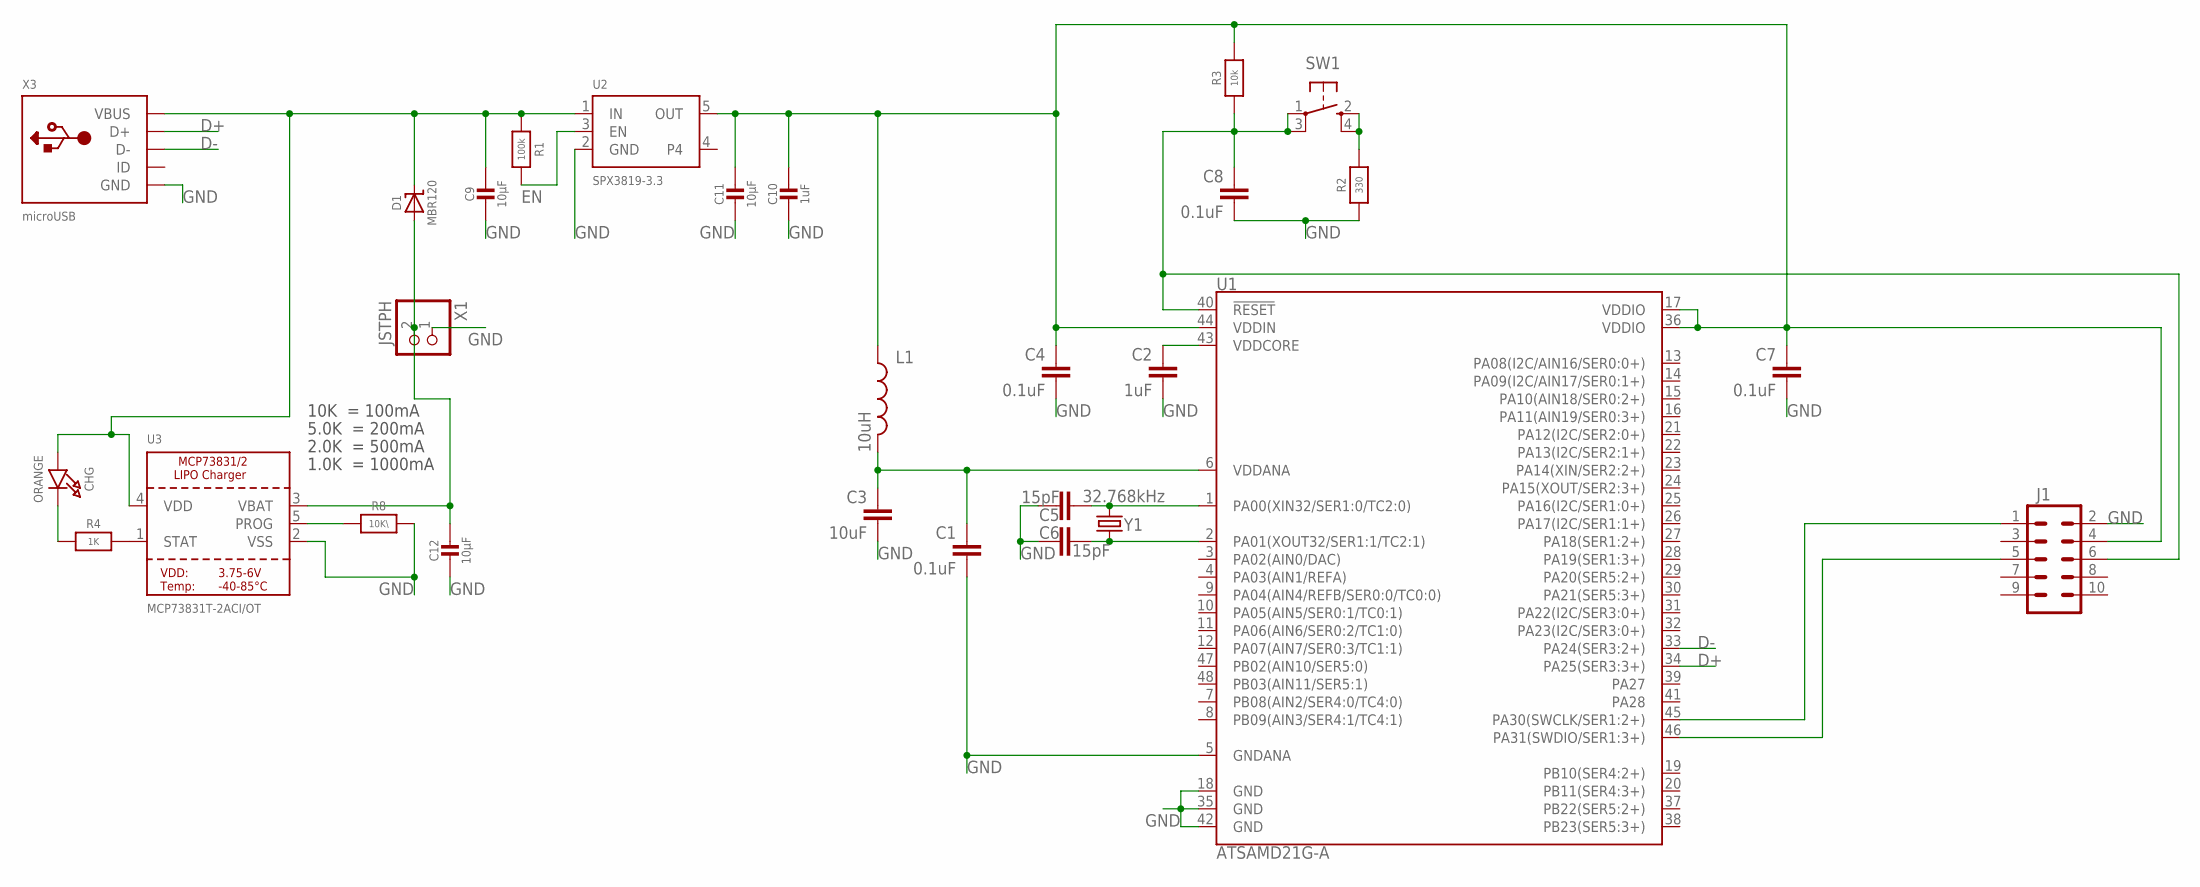
[picture p43: schematic SAMD21.sch]

Parts:
C1, C4, C7, C8: 0.1uF; 0402-CAP
C2: 1uF; 0402-CAP
C3: 10uF; 0402-CAP
C5, C6: 15pF; 0402-CAP
C9, C11, C12: 10µF; 0805-NO
C10: 1uF; 0603-NO
CHG: ORANGE; CHIPLED_0805_NOOUTLINE
D1: MBR120; SOD-123
J1: M05X2SHD_LOCK; 2X5-SHROUDED_LOCK
L1: 10uH; 0603
R1: 100k; 0603-NO
R2: 330; 0603-NO
R3: 10k; 0603-NO
R4: 1K; 0603-NO
R8: 10K\; 0603-NO
SW1: SPST_TACT-KMR2; KMR2
U1: ATSAMD21G-A; TQFP-48
U2: SPX3819-3.3; SOT23-5
U3: MCP73831T-2ACI/OT; SOT23-5
X1: JSTPH; JSTPH2
X3: microUSB; 4UCONN_20329_V2
Y1: 32.768kHz; CRYSTAL-SMD-3.2X1.5MM

Connections:
!RESET: C8.1, J1.6, R3.1, SW1.1, SW1.3 (P1), U1.40 (!RESET!)
D+: U1.34 (PA25(SER3:3+)), X3.D+
D-: U1.33 (PA24(SER3:2+)), X3.D-
EN: R1.2, U2.3 (EN)
GND: C1.2, C2.2, C3.2, C4.2, C5.1, C6.2, C7.2, C8.2, C9.2, C10.2, C11.2, C12.2, J1.2, R2.1, R8.2, U1.5 (GNDANA), U1.18 (GND), U1.35 (GND), U1.42 (GND), U2.2 (GND), U3.2 (VSS), X1.1, X3.BASE@1 (GND)
unnamed: C2.1, U1.43 (VDDCORE)
unnamed: C5.2, Y1.P$2 (2)
unnamed: J1.1, U1.45 (PA30(SWCLK/SER1:2+))
unnamed: C6.1, Y1.P$1 (1)
unnamed: J1.5, U1.46 (PA31(SWDIO/SER1:3+))
unnamed: R2.2, SW1.2 (S), SW1.4 (S1)
unnamed: C12.1, D1.A, U3.3 (VBAT), X1.2
unnamed: CHG.C, R4.1
unnamed: R4.2, U3.1 (STAT)
unnamed: R8.1, U3.5 (PROG)
unnamed: C9.1, CHG.A, D1.C, R1.1, U2.1 (IN), U3.4 (VDD), X3.VBUS
OUT: C4.1, C7.1, C10.1, C11.1, J1.4, L1.1, R3.2, U1.17 (VDDIO), U1.36 (VDDIO), U1.44 (VDDIN), U2.5 (OUT)
VDDANA: C1.1, C3.1, L1.2, U1.6 (VDDANA)

Notes on the sheet:
10K = 100mA
5.0K = 200mA
2.0K = 500mA
1.0K = 1000mA
