ImagineXYZ/GPSPassive/Hardware/Flash/TestArduino/PruebaSerialFlash/.ino.cpp

#ifdef __IN_ECLIPSE__
//This is a automatic generated file
//Please do not modify this file
//If you touch this file your change will be overwritten during the next build
//This file has been generated on 2016-08-18 16:29:57

#include "Arduino.h"
#include "Arduino.h"
#include <SPI.h>
#include "flash.h"
void setup() ;
void loop() ;

#include "PruebaSerialFlash.ino"


#endif
