ImagineXYZ/GPSPassive/(commit log)

2016-07-04 Eagle Files
    Eagle files for GPS passive technology. Uploading.
    [RAC.brd, RAC.sch]
2016-07-05 Agrega Eagle files actualizados, firmware de prueba, conexiones
2016-07-07 Corrige problemas de espacio entre las pistas para CNC
2016-07-08 Agrega carpetas y documentación para FONA - GSM808
2016-07-09 Estructura inicial de memoria FLash
2016-07-09 Estructura Inicial de memoria SD
2016-07-09 Mover Notas a la carpeta docs
2016-07-11 Agrega el esquemático para el SIM808
    [SIM808.sch]
2016-07-12 Información general de pins y doc de notas
2016-07-12 Corrige el esquemático para el SIM808
    [SIM808.sch]
2016-07-12 Agrega lista de partes para SIM808
2016-07-12 Actualiza lista de partes
2016-07-12 Creación de readme
2016-07-12 Datos de pines Flash y recomendaciones
2016-07-12 SIMCOM
    Agrega link de proveedror de SIMCOM
2016-07-12 Documento de Flash, conflicto merge solucion
2016-07-12 Crea carpeta para SAMD21
2016-07-12 Bluetooth
    Agrega documentos relacionados con el Bluetooth
2016-07-19 Agrega esquemático para SAMD21
    [SAMD21.sch]
2016-07-19 Agrega JTAG a SAMD21
    [SAMD21.sch]
2016-07-19 Corrige error en tierra de JTAG para SAMD21
    [SAMD21.sch]
2016-07-28 Corrige error en regulador, amplía pads
    [RAC.brd]
2016-07-29 Actualiza la biblioteca para RAC
2016-08-12 Agrega cambios en el .brd
    [RAC.brd]
2016-08-12 Agrega antena para BT en SIM808
    [SIM808.sch]
2016-08-13 Agrega manual de referencia de nRF51
2016-08-13 Agrega esquemático para todos los sub módulos
    [GPSPassive.sch]
2016-08-17 Agrega esquemático para nRF51822
    [BLE.sch]
2016-08-17 Corrige error en ID de pines ADC
2016-08-18 Agrega board principal
    [GPSPassive.brd, GPSPassive.sch]
2016-08-19 Corrige error en asignación de pines
2016-08-19 Cambia el ancho de pistas a 0.6096mm
    [RAC.brd]
2016-08-20 Corrige colocación de LED
    [GPSPassive.brd, GPSPassive.sch]
2016-08-23 Flash memory smd Footprint Eagle Device, DS Part, DS Breakout
    [S70FL01_Breakout.pcb, S70FL01_Breakout.sch, ~S70FL01_Breakout.pcb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]
2016-08-26 Pines de acuerdo al mas reciente archivo de Eagle
    Cambio en la asignación de pines
2016-08-26 Corrige inversión de pines TX y RX para BLE
    [GPSPassive.brd, GPSPassive.sch, RAC.brd, RAC.sch]
2016-08-26 Agrega detalles sobre pin 16
2016-08-26 Agrega archivo de debug para pcb
2016-08-30 Modificaciones lógica BLE y debug flag
    Se aumenta el buffer de recepción del BLE, delay en el envío del BLE
    para evitar conflictos en la RAM del bluetooth y bandera de control para
    el debugging, condicional en loop principal para ble.avalaible
2016-08-30 Flag Debug en el init del Serial.
2016-08-31 Breakout board memoria FLASH
    [prueba.kicad_pcb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]
2016-09-02 Prueba Flash Arduino
2016-09-02 Bandera de debug y otros docs
    Bandera para debug con GPRS, Build of materials y SIM/SD holder docs
2016-09-08 Componentes nuevos en el BOM
    Carpetas de FONA y SD
2016-09-23 Mejora de algoritmo BT
2016-09-30 Fotos de los avances
    Pics
2016-09-30 Completa protocolo de BT
2016-10-07 Agrega diagrama de secuencia del protocolo para BT
2016-10-27 Agrega función de hash y lectura de archivos
2016-12-01 Agrega pruebas iniciales para geofencing
2016-12-15 Agrega biblioteca para quadtree
2017-01-14 Agrega pruebas de quadtree
